JRKashani/Arduino/last_chance/docs/diagrams/distance-sensors-wiring.png

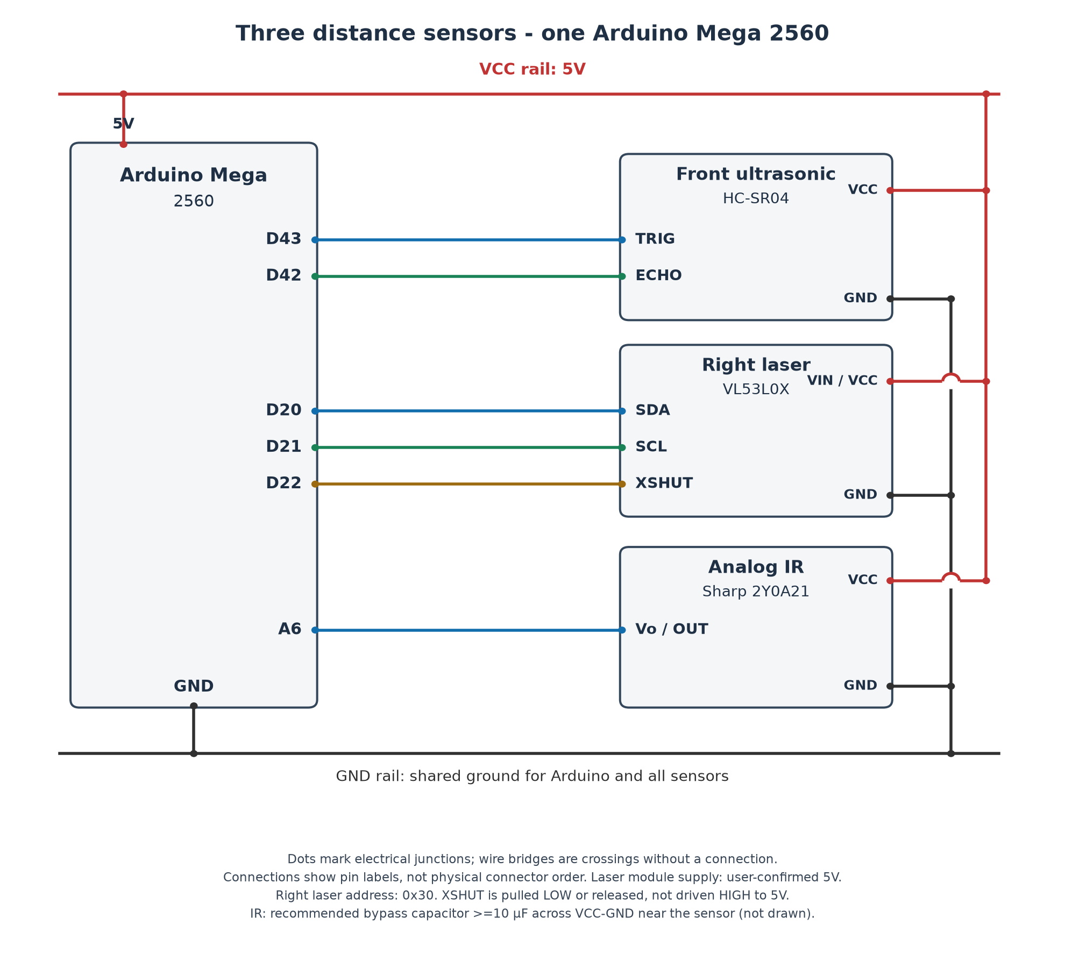
last_chance/docs/diagrams/distance-sensors-wiring.png
