JRKashani/Arduino/last_chance/docs/diagrams/imu-wiring.png

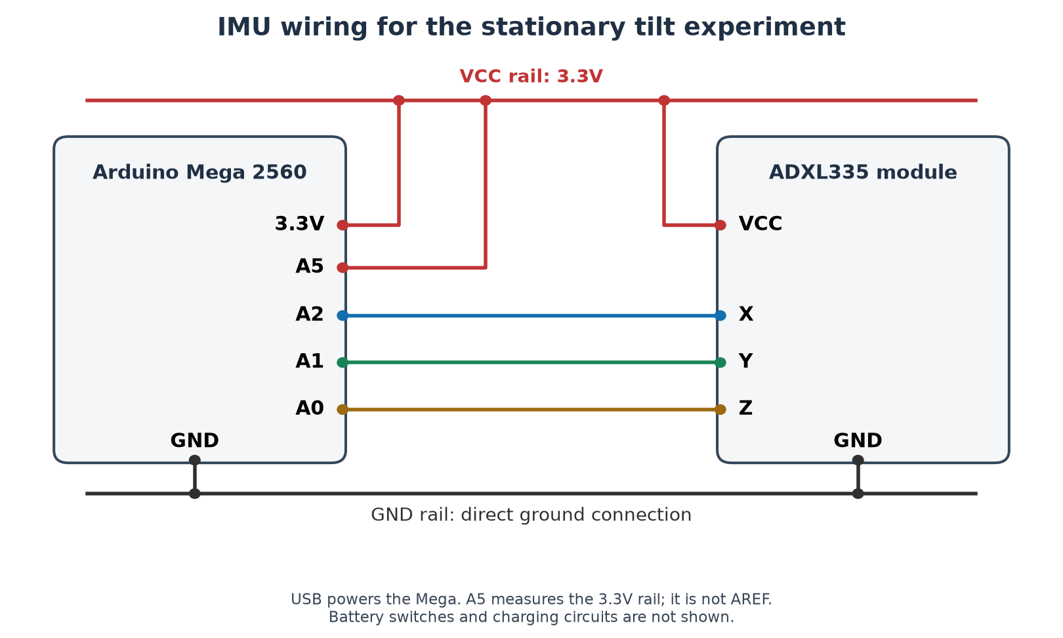
last_chance/docs/diagrams/imu-wiring.png
