JRKashani/Arduino/last_chance/docs/distance-results-2026-10-11/comparison/three-sensor-characteristic.pdf

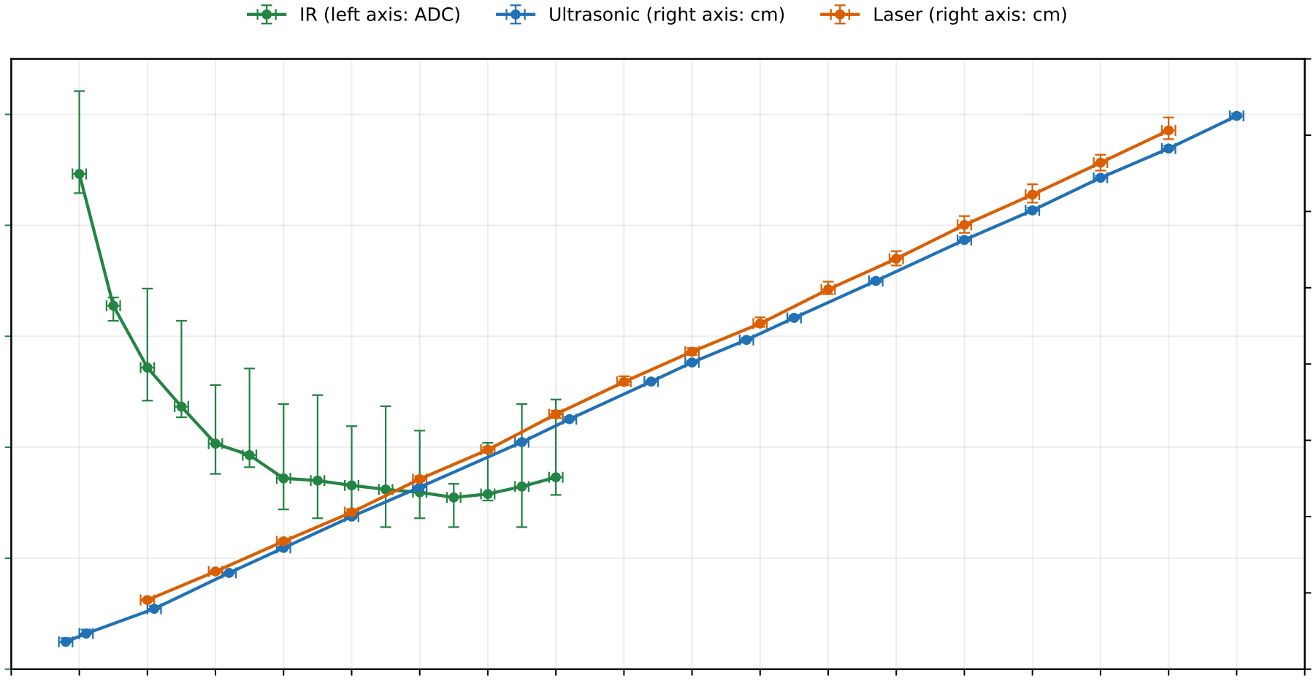
[picture p6: figure]
IR (left axis: ADC); Ultrasonic (right axis: cm); Laser (right axis: cm)

0 | 10 | 20 | 30 | 40 | 50 | 60 | 70 | 80 | 90 | 100 | 110 | 120 | 130 | 140 | 150 | 160 | 170 | 180 | 190

### Distance measured with tape, from sensor face (cm)

0

100

200

300

400

500

### IR output (ADC counts)

# Three-sensor distance characteristic

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
### Ultrasonic / laser reported distance (cm)

Points: mean of 3 accepted repeats. Vertical bars: minimum–maximum of all accepted samples.

Horizontal bars: ±1 cm tape-measure uncertainty (2 cm total width).
US uses existing calibration; laser uses reported cm. IR remains in ADC counts.
Laser mounting changed around 60 cm; this curve retains the original run.
The two y-axes use independent scales; curve intersections do not imply equal outputs.
