JRKashani/Arduino/last_chance/docs/distance-results-2026-10-11/raw-sensor-graphs/us-raw.pdf

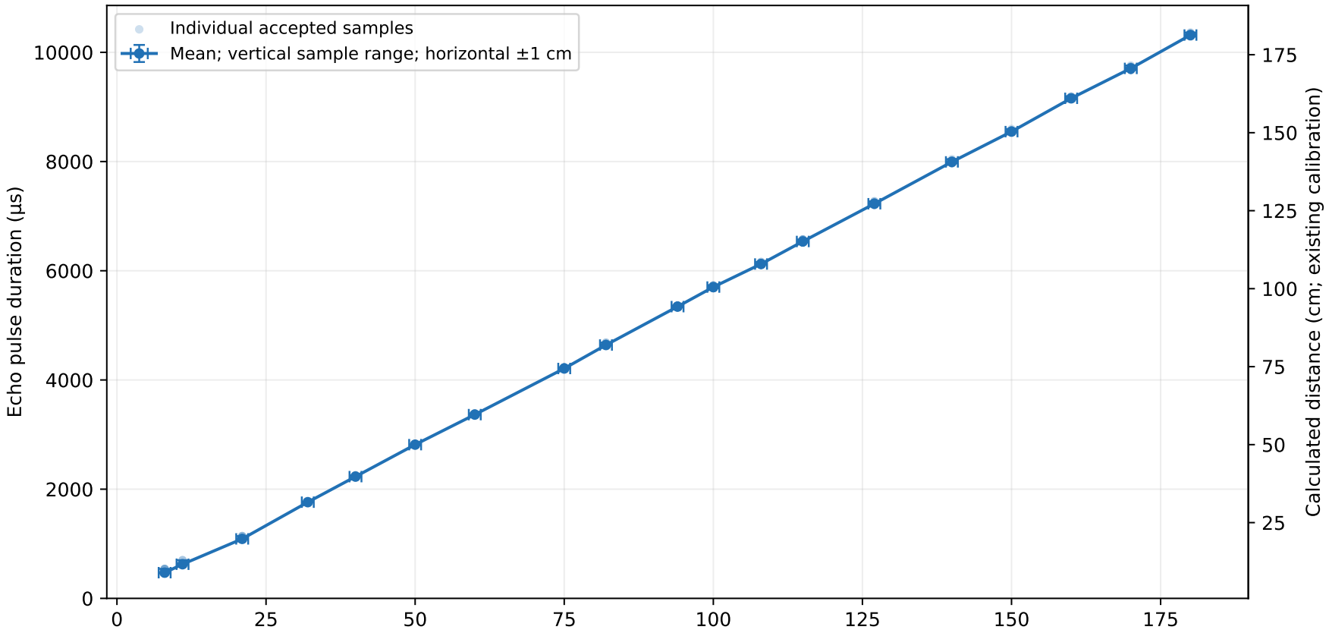
[picture p7: figure]
Calculated distance (cm; existing calibration); Echo pulse duration (µs); Individual accepted samples

Tape-measured distance from sensor face (cm)

## Ultrasonic sensor — raw echo time

Mean; vertical sample range; horizontal ±1 cm

Points: equally weighted mean of 3 accepted repeats; faint dots: individual raw samples. Vertical bars: minimum–maximum of accepted samples. Horizontal bars: ±1 cm (2 cm total). Right axis: cm = (echo µs / 58) × 1.01535 + 0.7091. The same points and bars use both scales.
