JRKashani/Arduino/last_chance/docs/distance-results-2026-10-11/raw-sensor-graphs/plotted-data.csv

sensor | session | actual_cm | x_error_minus_cm | x_error_plus_cm | raw_mean | raw_min | raw_max | raw_unit | valid_samples | calculated_cm_mean | calculated_cm_min | calculated_cm_max
ir | 20261011T152446_019469Z_ir | 10.0 | 1 | 1 | 446.3333333333333 | 429 | 521 | ADC counts | 30
ir | 20261011T152446_019469Z_ir | 15.0 | 1 | 1 | 327.5333333333333 | 314 | 335 | ADC counts | 30
ir | 20261011T152446_019469Z_ir | 20.0 | 1 | 1 | 271.76666666666665 | 242 | 343 | ADC counts | 30
ir | 20261011T152446_019469Z_ir | 25.0 | 1 | 1 | 236.56666666666666 | 227 | 314 | ADC counts | 30
ir | 20261011T152446_019469Z_ir | 30.0 | 1 | 1 | 203.23333333333335 | 176 | 256 | ADC counts | 30
ir | 20261011T152446_019469Z_ir | 35.0 | 1 | 1 | 192.93333333333334 | 182 | 271 | ADC counts | 30
ir | 20261011T152446_019469Z_ir | 40.0 | 1 | 1 | 172.0 | 144 | 239 | ADC counts | 30
ir | 20261011T152446_019469Z_ir | 45.0 | 1 | 1 | 169.93333333333334 | 136 | 247 | ADC counts | 30
ir | 20261011T152446_019469Z_ir | 50.0 | 1 | 1 | 165.63333333333333 | 136 | 219 | ADC counts | 30
ir | 20261011T152446_019469Z_ir | 55.0 | 1 | 1 | 161.96666666666667 | 128 | 237 | ADC counts | 30
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
