JRKashani/Arduino/last_chance/docs/distance-results-2026-10-11/20261011T134101_190940Z_us/analysis/20261011T141951_366159Z/measurements.xlsx

Sheet: Experiment
Front HC-SR04
Curve definition | Minimum / mean / maximum of separate accepted capture means
schema | 1
created_utc | 2026-10-11T13:41:01.190940+00:00
sensor | us
sensor_description | Front HC-SR04
simulated | FALSE
points_cm | [200, 175, 150, 125, 100, 80, 60, 50, 40, 30, 25, 20, 15, 10]
repeats | 3
samples_per_capture | 10
period_ms | 500
settle_ms | 500
distance_origin | sensor_face
adc_reference_v | 5
adc_reference_source | nominal
firmware_config | {"US_SCALE": "1.015350", "US_OFFSET_CM": "0.709100", "US_TIMEOUT_US": "30000", "US_CALIBRATION_RANGE_CM": "15:150", "IR_PIN": "A6", "IR_MODEL": "GP2Y0A21YK0F", "ADC_REFERENCE": "AVCC", "LASER_PROFILE": "default_33ms_single_shot", "DISTANCE_ORIGIN": "sensor_face"}
firmware_version | 1.0.0
setup_notes

Sheet: Samples
point_index | target_cm | actual_cm | repeat | capture_id | included | decision | superseded_point | sequence | timestamp_ms | raw | valid | status | device_status | raw_cm | calibrated_cm | voltage
1 | 200 | 200 | 1 | 1 | FALSE | skipped | TRUE | 0 | 322189 | 0 | FALSE | NO_ECHO | -1
1 | 200 | 200 | 1 | 1 | FALSE | skipped | TRUE | 1 | 322289 | 0 | FALSE | NO_ECHO | -1
1 | 200 | 200 | 1 | 1 | FALSE | skipped | TRUE | 2 | 322390 | 0 | FALSE | NO_ECHO | -1
1 | 200 | 200 | 1 | 1 | FALSE | skipped | TRUE | 3 | 322490 | 0 | FALSE | NO_ECHO | -1
1 | 200 | 200 | 1 | 1 | FALSE | skipped | TRUE | 4 | 322590 | 0 | FALSE | NO_ECHO | -1
1 | 200 | 200 | 1 | 1 | FALSE | skipped | TRUE | 5 | 322690 | 0 | FALSE | NO_ECHO | -1
1 | 200 | 200 | 1 | 1 | FALSE | skipped | TRUE | 6 | 322790 | 0 | FALSE | NO_ECHO | -1
1 | 200 | 200 | 1 | 1 | FALSE | skipped | TRUE | 7 | 322890 | 0 | FALSE | NO_ECHO | -1
1 | 200 | 200 | 1 | 1 | FALSE | skipped | TRUE | 8 | 322990 | 0 | FALSE | NO_ECHO | -1
1 | 200 | 200 | 1 | 1 | FALSE | skipped | TRUE | 9 | 323090 | 0 | FALSE | NO_ECHO | -1
1 | 180 | 180 | 1 | 2 | TRUE | accepted | FALSE | 0 | 108954 | 4076 | TRUE | OK | -1 | 70.27586207 | 72.06369655
1 | 180 | 180 | 1 | 2 | TRUE | accepted | FALSE | 1 | 109454 | 3473 | TRUE | OK | -1 | 59.87931034 | 61.50755776
1 | 180 | 180 | 1 | 2 | TRUE | accepted | FALSE | 2 | 109954 | 3522 | TRUE | OK | -1 | 60.72413793 | 62.36535345
1 | 180 | 180 | 1 | 2 | TRUE | accepted | FALSE | 3 | 110454 | 3672 | TRUE | OK | -1 | 63.31034483 | 64.99125862
1 | 180 | 180 | 1 | 2 | TRUE | accepted | FALSE | 4 | 110954 | 3523 | TRUE | OK | -1 | 60.74137931 | 62.38285948
1 | 180 | 180 | 1 | 2 | TRUE | accepted | FALSE | 5 | 111454 | 3573 | TRUE | OK | -1 | 61.60344828 | 63.25816121
1 | 180 | 180 | 1 | 2 | TRUE | accepted | FALSE | 6 | 111954 | 3548 | TRUE | OK | -1 | 61.17241379 | 62.82051034
1 | 180 | 180 | 1 | 2 | TRUE | accepted | FALSE | 7 | 112454 | 3597 | TRUE | OK | -1 | 62.01724138 | 63.67830603
1 | 180 | 180 | 1 | 2 | TRUE | accepted | FALSE | 8 | 112954 | 3947 | TRUE | OK | -1 | 68.05172414 | 69.8054181
1 | 180 | 180 | 1 | 2 | TRUE | accepted | FALSE | 9 | 113454 | 3897 | TRUE | OK | -1 | 67.18965517 | 68.93011638

Sheet: Captures
point_index | point_id | target_cm | actual_cm | repeat | capture_id | decision | included | complete | samples | valid_samples | requested_samples | period_ms | settle_ms | raw_min | raw_mean | raw_max | raw_std | raw_cm_min | raw_cm_mean | raw_cm_max | raw_cm_std | calibrated_cm_min | calibrated_cm_mean | calibrated_cm_max | calibrated_cm_std | voltage_min | voltage_mean | voltage_max | voltage_std
1 | 2d2e0a82a0844c6d9f750905f05c7ea4 | 200 | 200 | 1 | 1 | skipped | FALSE | TRUE | 10 | 0 | 10 | 100 | 1000
1 | b7a7c84e476840808e9e09828e3fdaa0 | 180 | 180 | 1 | 2 | accepted | TRUE | TRUE | 10 | 10 | 10 | 500 | 500 | 3473 | 3682.8 | 4076 | 211.7135381 | 59.87931034 | 63.49655172 | 70.27586207 | 3.650233416 | 61.50755776 | 65.18032379 | 72.06369655 | 3.706264499

Sheet: Summary
point_index | target_cm | actual_cm | completed | accepted_captures | usable_captures | valid_samples | total_samples | within_nominal_range | within_us_calibration_range | three_usable_repeats | raw_min | raw_mean | raw_max | raw_std | raw_cm_min | raw_cm_mean | raw_cm_max | raw_cm_std | calibrated_cm_min | calibrated_cm_mean | calibrated_cm_max | calibrated_cm_std | voltage_min | voltage_mean | voltage_max | voltage_std | error_cm
1 | 180 | 180 | FALSE | 1 | 1 | 10 | 10 | TRUE | FALSE | FALSE | 3682.8 | 3682.8 | 3682.8 | 0 | 63.49655172 | 63.49655172 | 63.49655172 | 0 | 65.18032379 | 65.18032379 | 65.18032379 | 0 |  |  |  |  | -114.8196762
