JRKashani/Arduino/last_chance/docs/distance-results-2026-10-11/20261011T152053_543501Z_laser/analysis/20261011T152435_927208Z/summary.csv

point_index | target_cm | actual_cm | completed | accepted_captures | usable_captures | valid_samples | total_samples | within_nominal_range | within_us_calibration_range | three_usable_repeats | raw_min | raw_mean | raw_max | raw_std | raw_cm_min | raw_cm_mean | raw_cm_max | raw_cm_std | calibrated_cm_min | calibrated_cm_mean | calibrated_cm_max | calibrated_cm_std | voltage_min | voltage_mean | voltage_max | voltage_std | error_cm
4 | 50.0 | 50.0 | True | 3 | 3 | 30 | 30 | True |  | True | 510.7 | 511.73333333333335 | 512.9 | 1.1060440015357957 | 51.07 | 51.17333333333333 | 51.29 | 0.11060440015358002 | 51.07 | 51.17333333333333 | 51.29 | 0.11060440015358002 |  |  |  |  | 1.173333333333332
3 | 60.0 | 60.0 | True | 3 | 3 | 30 | 30 | True |  | True | 618.6 | 620.1 | 621 | 1.3076696830621994 | 61.86 | 62.01 | 62.1 | 0.1307669683062211 | 61.86 | 62.01 | 62.1 | 0.1307669683062211 |  |  |  |  | 2.009999999999998
2 | 70.0 | 70.0 | True | 3 | 3 | 30 | 30 | True |  | True | 718.2 | 719.7666666666667 | 720.9 | 1.4011899704655526 | 71.82 | 71.97666666666666 | 72.09 | 0.14011899704656258 | 71.82 | 71.97666666666666 | 72.09 | 0.14011899704656258 |  |  |  |  | 1.9766666666666595
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
