JRKashani/Arduino/last_chance/docs/distance-results-2026-10-11/raw-sensor-graphs/ir-reference-trace.csv

distance_cm | approximate_voltage_V | equivalent_ADC_at_4_71V
1 | 0.8 | 173.7579617834395
2 | 1.12 | 243.26114649681534
3 | 1.55 | 336.65605095541406
4 | 1.92 | 417.0191082802547
5 | 1.8 | 390.95541401273886
6 | 2.14 | 464.8025477707007
7 | 2.48 | 538.6496815286624
8 | 2.62 | 569.0573248407644
9 | 2.59 | 562.5414012738853
10 | 2.45 | 532.1337579617835
12 | 2.2 | 477.8343949044587
14 | 2.01 | 436.56687898089166
16 | 1.63 | 354.03184713375794
18 | 1.5 | 325.79617834394907
20 | 1.4 | 304.0764331210191
22 | 1.29 | 280.1847133757962
25 | 1.16 | 251.94904458598722
28 | 1.05 | 228.05732484076435
30 | 0.99 | 215.02547770700636
35 | 0.9 | 195.47770700636943
40 | 0.76 | 165.07006369426753
45 | 0.69 | 149.86624203821654
50 | 0.63 | 136.8343949044586
55 | 0.6 | 130.3184713375796
60 | 0.58 | 125.97452229299361
65 | 0.54 | 117.28662420382167
70 | 0.51 | 110.77070063694268
75 | 0.5 | 108.59872611464968
80 | 0.49 | 106.42675159235668
