JRKashani/Arduino/last_chance/docs/distance-results-2026-10-11/20261011T152053_543501Z_laser/analysis/20261011T152435_927208Z/measurements.xlsx

Sheet: Experiment
Right VL53L0X
Curve definition | Minimum / mean / maximum of separate accepted capture means
schema | 2
created_utc | 2026-10-11T15:20:53.543501+00:00
sensor | laser
sensor_description | Right VL53L0X
simulated | FALSE
collection_mode | open_ended
repeats | 3
samples_per_capture | 10
period_ms | 500
settle_ms | 500
distance_origin | sensor_face
adc_reference_v | 5
adc_reference_source | nominal
firmware_config | {"US_SCALE": "1.015350", "US_OFFSET_CM": "0.709100", "US_TIMEOUT_US": "30000", "US_CALIBRATION_RANGE_CM": "15:150", "IR_PIN": "A6", "IR_MODEL": "GP2Y0A21YK0F", "ADC_REFERENCE": "AVCC", "LASER_PROFILE": "long_range_33ms_single_shot", "DISTANCE_ORIGIN": "sensor_face"}
firmware_version | 1.2.0
setup_notes
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
