JRKashani/Arduino/last_chance/docs/distance-results-2026-10-11/20261011T152053_543501Z_laser/analysis/20261011T152435_927208Z/samples.csv

point_index | target_cm | actual_cm | repeat | capture_id | included | decision | superseded_point | sequence | timestamp_ms | raw | valid | status | device_status | raw_cm | calibrated_cm | voltage
1 | 91.0 | 91.0 | 1 | 1 | True | accepted | False | 0 | 56576 | 958 | True | OK | 11 | 95.8 | 95.8
1 | 91.0 | 91.0 | 1 | 1 | True | accepted | False | 1 | 57076 | 955 | True | OK | 11 | 95.5 | 95.5
1 | 91.0 | 91.0 | 1 | 1 | True | accepted | False | 2 | 57576 | 956 | True | OK | 11 | 95.6 | 95.6
1 | 91.0 | 91.0 | 1 | 1 | True | accepted | False | 3 | 58076 | 956 | True | OK | 11 | 95.6 | 95.6
1 | 91.0 | 91.0 | 1 | 1 | True | accepted | False | 4 | 58576 | 948 | True | OK | 11 | 94.8 | 94.8
1 | 91.0 | 91.0 | 1 | 1 | True | accepted | False | 5 | 59076 | 946 | True | OK | 11 | 94.6 | 94.6
1 | 91.0 | 91.0 | 1 | 1 | True | accepted | False | 6 | 59576 | 950 | True | OK | 11 | 95.0 | 95.0
1 | 91.0 | 91.0 | 1 | 1 | True | accepted | False | 7 | 60076 | 964 | True | OK | 11 | 96.4 | 96.4
1 | 91.0 | 91.0 | 1 | 1 | True | accepted | False | 8 | 60576 | 955 | True | OK | 11 | 95.5 | 95.5
1 | 91.0 | 91.0 | 1 | 1 | True | accepted | False | 9 | 61076 | 950 | True | OK | 11 | 95.0 | 95.0
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
