JRKashani/Arduino/last_chance/docs/distance-results-2026-10-11/20261011T144802_531804Z_laser/analysis/20261011T150552_051989Z/captures.csv

point_index | point_id | target_cm | actual_cm | repeat | capture_id | decision | included | complete | samples | valid_samples | requested_samples | period_ms | settle_ms | raw_min | raw_mean | raw_max | raw_std | raw_cm_min | raw_cm_mean | raw_cm_max | raw_cm_std | calibrated_cm_min | calibrated_cm_mean | calibrated_cm_max | calibrated_cm_std | voltage_min | voltage_mean | voltage_max | voltage_std
1 | 955a29c8fc8f48d6ac156793464ac0b9 | 170.0 | 170.0 | 1 | 1 | accepted | True | True | 10 | 10 | 10 | 500 | 500 | 1737 | 1761 | 1800 | 20.741798914805393 | 173.7 | 176.1 | 180.0 | 2.074179891480541 | 173.7 | 176.1 | 180.0 | 2.074179891480541
1 | 955a29c8fc8f48d6ac156793464ac0b9 | 170.0 | 170.0 | 2 | 2 | accepted | True | True | 10 | 10 | 10 | 500 | 500 | 1764 | 1775.1 | 1808 | 12.314851016376753 | 176.4 | 177.51 | 180.8 | 1.2314851016376784 | 176.4 | 177.51 | 180.8 | 1.2314851016376784
1 | 955a29c8fc8f48d6ac156793464ac0b9 | 170.0 | 170.0 | 3 | 3 | accepted | True | True | 10 | 10 | 10 | 500 | 500 | 1749 | 1760.8 | 1776 | 9.589345939924973 | 174.9 | 176.07999999999998 | 177.6 | 0.9589345939924981 | 174.9 | 176.07999999999998 | 177.6 | 0.9589345939924981
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
