JRKashani/Arduino/last_chance/docs/distance-results-2026-10-11/20261011T144802_531804Z_laser/analysis/20261011T150552_051989Z/samples.csv

point_index | target_cm | actual_cm | repeat | capture_id | included | decision | superseded_point | sequence | timestamp_ms | raw | valid | status | device_status | raw_cm | calibrated_cm | voltage
1 | 170.0 | 170.0 | 1 | 1 | True | accepted | False | 0 | 58801 | 1742 | True | OK | 11 | 174.2 | 174.2
1 | 170.0 | 170.0 | 1 | 1 | True | accepted | False | 1 | 59301 | 1758 | True | OK | 11 | 175.8 | 175.8
1 | 170.0 | 170.0 | 1 | 1 | True | accepted | False | 2 | 59801 | 1758 | True | OK | 11 | 175.8 | 175.8
1 | 170.0 | 170.0 | 1 | 1 | True | accepted | False | 3 | 60301 | 1753 | True | OK | 11 | 175.3 | 175.3
1 | 170.0 | 170.0 | 1 | 1 | True | accepted | False | 4 | 60801 | 1737 | True | OK | 11 | 173.7 | 173.7
1 | 170.0 | 170.0 | 1 | 1 | True | accepted | False | 5 | 61301 | 1748 | True | OK | 11 | 174.8 | 174.8
1 | 170.0 | 170.0 | 1 | 1 | True | accepted | False | 6 | 61801 | 1794 | True | OK | 11 | 179.4 | 179.4
1 | 170.0 | 170.0 | 1 | 1 | True | accepted | False | 7 | 62301 | 1766 | True | OK | 11 | 176.6 | 176.6
1 | 170.0 | 170.0 | 1 | 1 | True | accepted | False | 8 | 62801 | 1754 | True | OK | 11 | 175.4 | 175.4
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
