JRKashani/Arduino/last_chance/docs/distance-results-2026-10-11/20261011T144802_531804Z_laser/analysis/20261011T150552_051989Z/summary.csv

point_index | target_cm | actual_cm | completed | accepted_captures | usable_captures | valid_samples | total_samples | within_nominal_range | within_us_calibration_range | three_usable_repeats | raw_min | raw_mean | raw_max | raw_std | raw_cm_min | raw_cm_mean | raw_cm_max | raw_cm_std | calibrated_cm_min | calibrated_cm_mean | calibrated_cm_max | calibrated_cm_std | voltage_min | voltage_mean | voltage_max | voltage_std | error_cm
16 | 20.0 | 20.0 | True | 3 | 3 | 30 | 30 | True |  | True | 225.6 | 226.63333333333333 | 227.7 | 1.0503967504392457 | 22.560000000000002 | 22.663333333333334 | 22.77 | 0.10503967504392353 | 22.560000000000002 | 22.663333333333334 | 22.77 | 0.10503967504392353 |  |  |  |  | 2.663333333333334
15 | 30.0 | 30.0 | True | 3 | 3 | 30 | 30 | True |  | True | 320 | 320.1333333333333 | 320.4 | 0.23094010767583717 | 32.0 | 32.013333333333335 | 32.04 | 0.02309401076758454 | 32.0 | 32.013333333333335 | 32.04 | 0.02309401076758454 |  |  |  |  | 2.0133333333333354
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
