JRKashani/Arduino/last_chance/docs/imu-results-2026-10-11/tables/x-tilt-g.csv

phone_angle_deg | X_g | Y_g | Z_g | surface | heading | loops | source_trial_ids
-34.256 | -0.551897834 | 0.043946615 | 0.8414317060000001 | S5 | 0 | 1;2 | 43;47
-20.002 | -0.33380335499999997 | 0.06861187499999999 | 0.949079606 | S4 | 0 | 1;2 | 34;38
-14.01 | -0.22895164899999998 | 0.069854763 | 0.979319847 | S3 | 0 | 1;2 | 24;28
-8.754 | -0.141043585 | 0.069884043 | 0.99499125 | S2 | 0 | 1;2 | 15;19
-4.257 | -0.060359365 | 0.064798806 | 1.002617856 | S1 | 0 | 1;2 | 5;9
0.0 | 0.014815390666666668 | 0.0712180845 | 1.0043523600833333 | FLAT_REFERENCE | 0 | 0 | 1;2;3;4;13;14;23;33;42;51
4.257 | 0.08401466 | 0.07240590999999999 | 1.002087491 | S1 | 180 | 1;2 | 7;11
8.754 | 0.16258007800000002 | 0.071297232 | 0.990873464 | S2 | 180 | 1;2 | 17;21
14.01 | 0.263296295 | 0.07153019099999999 | 0.968863776 | S3 | 180 | 1;2 | 26;30
20.002 | 0.353608397 | 0.063222719 | 0.9381679439999999 | S4 | 180 | 1;2 | 36;40
34.256 | 0.574385689 | 0.09277275499999998 | 0.814546383 | S5 | 180 | 1;2 | 45;49
