JRKashani/Arduino/last_chance/docs/imu-results-2026-10-11/tables/x-tilt-raw.csv

phone_angle_deg | X_raw | Y_raw | Z_raw | surface | heading | loops | source_trial_ids
-34.256 | 307.41200000000003 | 354.66499999999996 | 406.256 | S5 | 0 | 1;2 | 43;47
-20.002 | 322.96 | 356.38 | 413.906 | S4 | 0 | 1;2 | 34;38
-14.01 | 330.727 | 356.756 | 416.40999999999997 | S3 | 0 | 1;2 | 24;28
-8.754 | 337.04200000000003 | 356.78 | 417.561 | S2 | 0 | 1;2 | 15;19
-4.257 | 342.415 | 355.99199999999996 | 417.615 | S1 | 0 | 1;2 | 5;9
0.0 | 347.996 | 356.66433333333333 | 417.98466666666667 | FLAT_REFERENCE | 0 | 0 | 1;2;3;4;13;14;23;33;42;51
4.257 | 352.861 | 356.662 | 417.719 | S1 | 180 | 1;2 | 7;11
8.754 | 358.84799999999996 | 356.946 | 417.34000000000003 | S2 | 180 | 1;2 | 17;21
14.01 | 365.841 | 356.74800000000005 | 415.509 | S3 | 180 | 1;2 | 26;30
20.002 | 372.26599999999996 | 356.111 | 413.262 | S4 | 180 | 1;2 | 36;40
34.256 | 388.005 | 358.18600000000004 | 404.32500000000005 | S5 | 180 | 1;2 | 45;49
