JRKashani/Arduino/last_chance/docs/imu-results-2026-10-11/tables/y-tilt-g.csv

signed_slope_magnitude_deg | X_g | Y_g | Z_g | surface | heading | loops | source_trial_ids
-34.256 | -0.003719950999999999 | -0.487164155 | 0.884058954 | S5 | 90 | 1;2 | 44;48
-20.002 | 0.003487446 | -0.272733036 | 0.9722979439999999 | S4 | 90 | 1;2 | 35;39
-14.01 | 0.009707843 | -0.16729912800000002 | 0.9946949030000001 | S3 | 90 | 1;2 | 25;29
-8.754 | 0.004741636 | -0.075351169 | 1.0058388169999999 | S2 | 90 | 1;2 | 16;20
-4.257 | 0.00883175 | 0.0006589870000000001 | 1.007943927 | S1 | 90 | 1;2 | 6;10
0.0 | 0.014815390666666668 | 0.0712180845 | 1.0043523600833333 | FLAT_REFERENCE | 0 | 0 | 1;2;3;4;13;14;23;33;42;51
4.257 | 0.007562078999999999 | 0.14240960800000002 | 0.997535274 | S1 | 270 | 1;2 | 8;12
8.754 | 0.010429623999999998 | 0.21706910000000001 | 0.98330801 | S2 | 270 | 1;2 | 18;22
14.01 | 0.015343746 | 0.308359131 | 0.958333969 | S3 | 270 | 1;2 | 27;31
20.002 | 0.000727585 | 0.40931196400000003 | 0.9176683889999999 | S4 | 270 | 1;2 | 37;41
34.256 | 0.013116209 | 0.613324576 | 0.790872739 | S5 | 270 | 1;2 | 46;50
