JRKashani/Arduino/last_chance/docs/distance-results-2026-10-11/20261011T134101_190940Z_us/analysis/20261011T141951_366159Z/characteristic.png

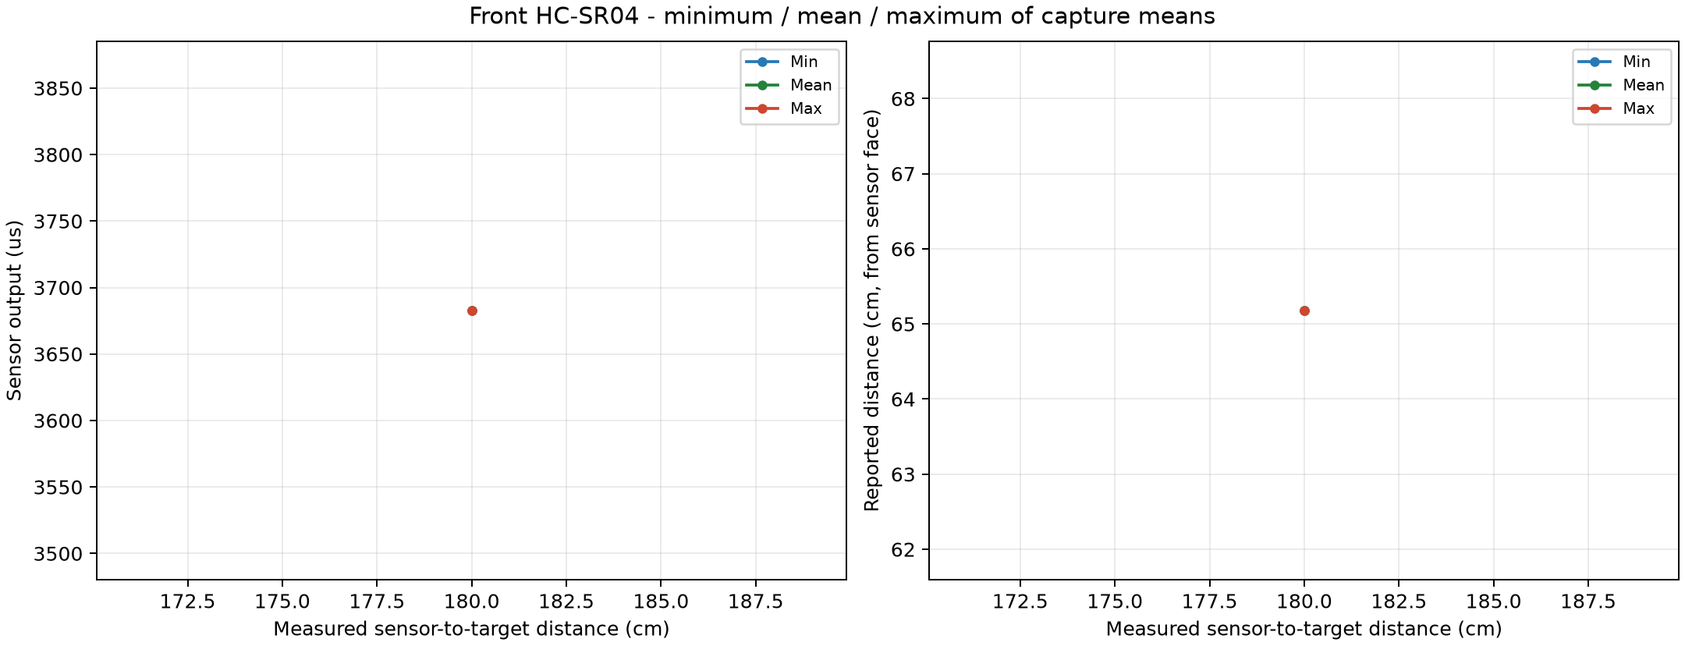
last_chance/docs/distance-results-2026-10-11/20261011T134101_190940Z_us/analysis/20261011T141951_366159Z/characteristic.png
