JRKashani/Arduino/last_chance/docs/distance-results-2026-10-11/20261011T152446_019469Z_ir/analysis/20261011T153412_479901Z/characteristic.png

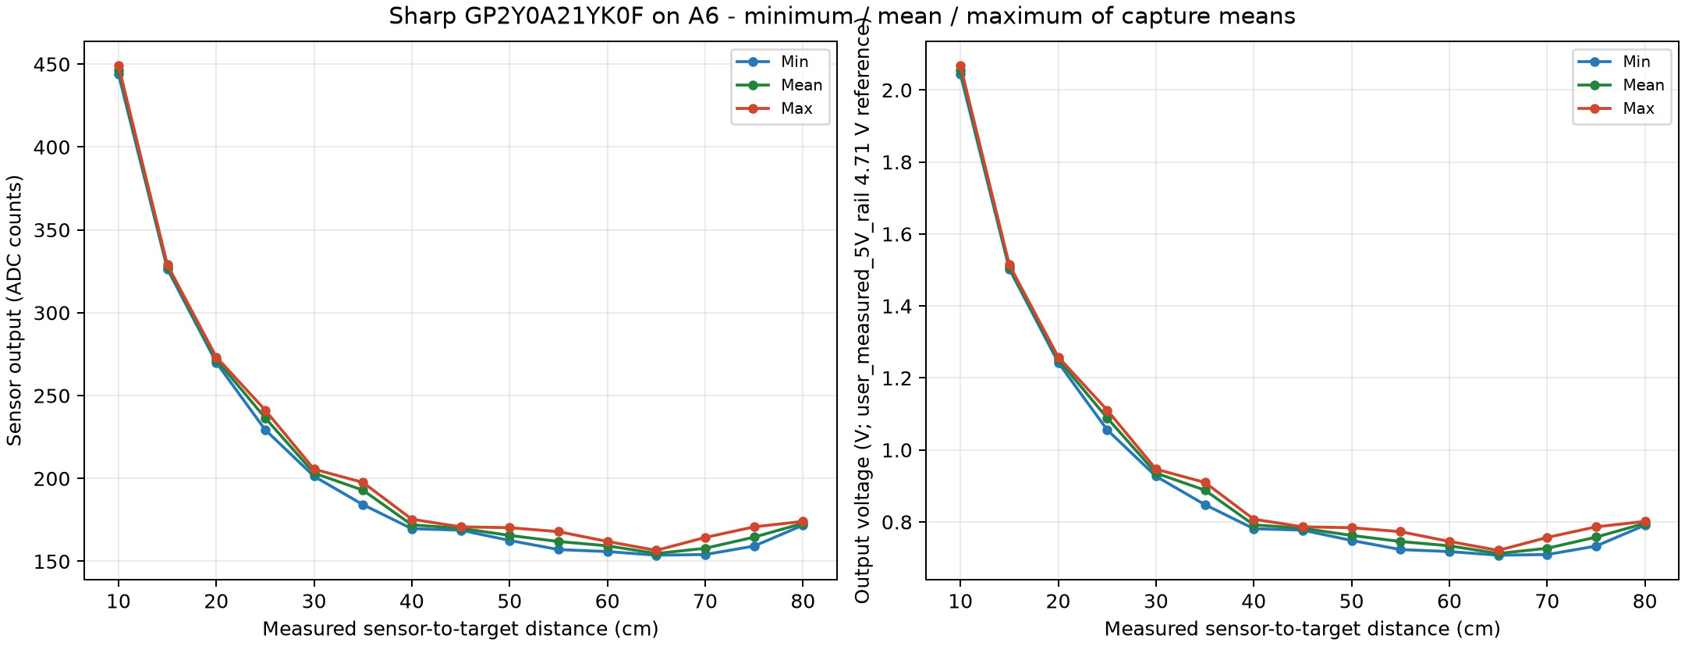
last_chance/docs/distance-results-2026-10-11/20261011T152446_019469Z_ir/analysis/20261011T153412_479901Z/characteristic.png
