JRKashani/Arduino/last_chance/docs/distance-results-2026-10-11/raw-sensor-graphs/ir-raw.png

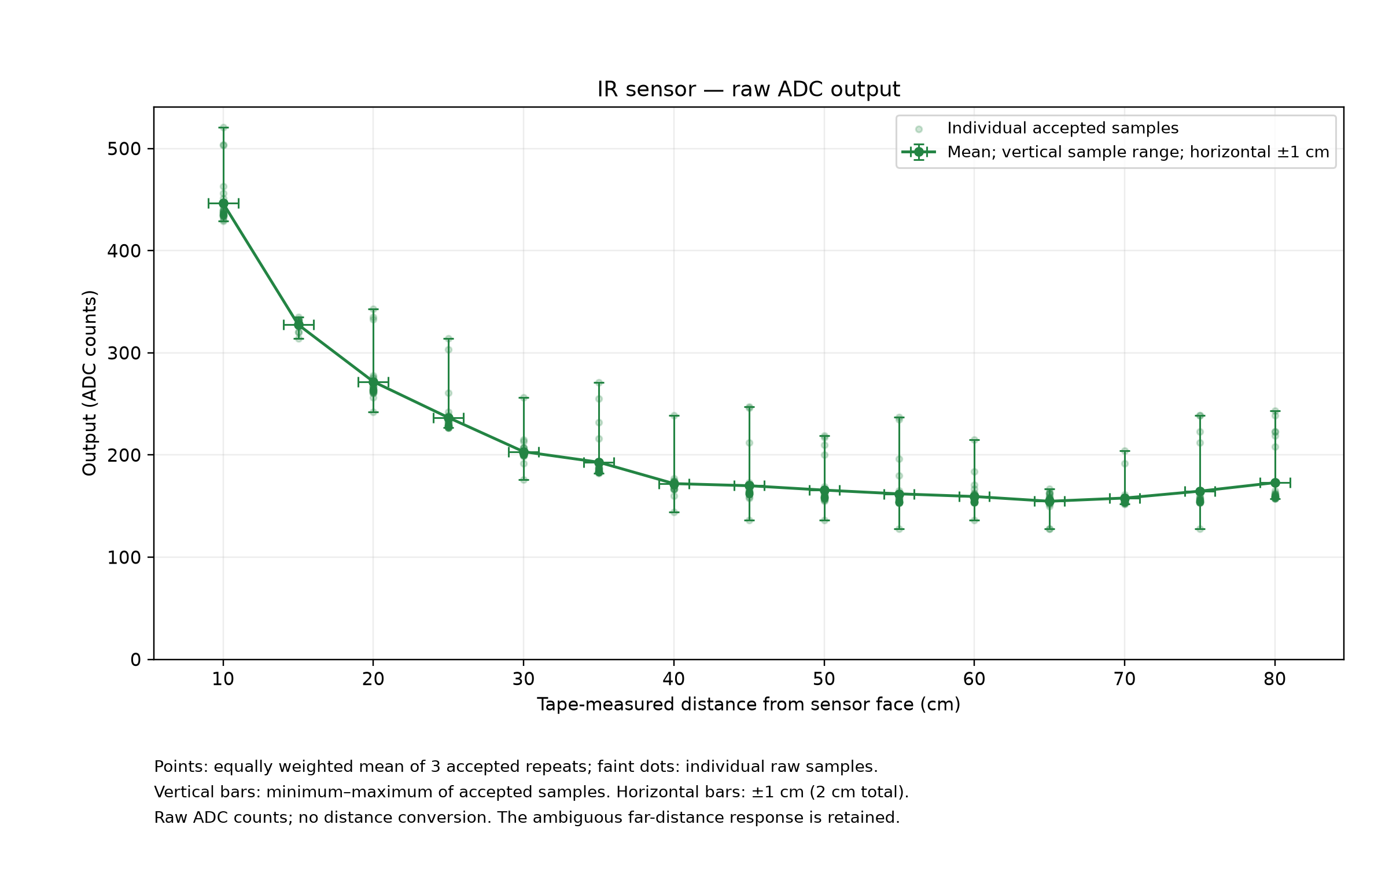
last_chance/docs/distance-results-2026-10-11/raw-sensor-graphs/ir-raw.png
