JRKashani/Arduino/last_chance/docs/imu-results-2026-10-11/calibration-review.png

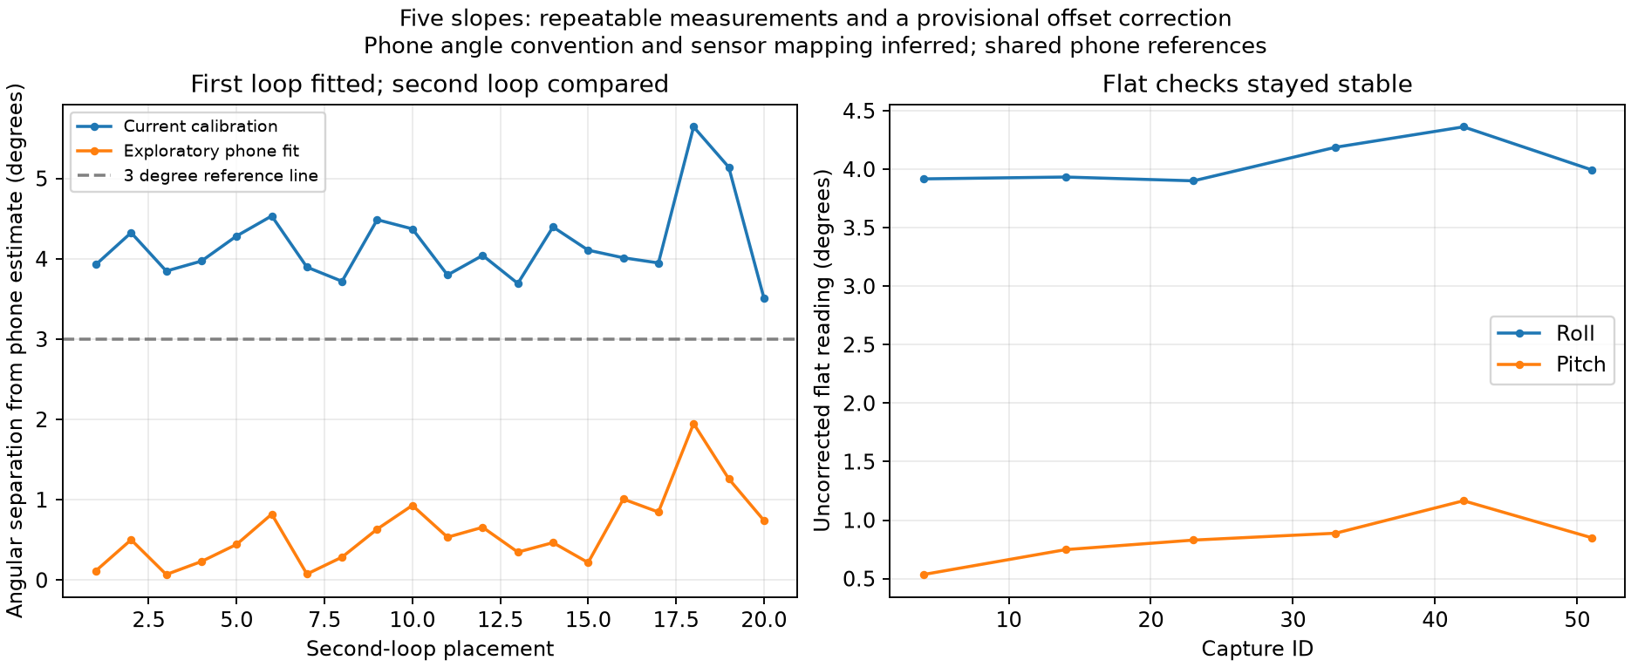
last_chance/docs/imu-results-2026-10-11/calibration-review.png
