JRKashani/Arduino/last_chance/docs/imu-results-2026-10-11/tables/measured-tables.png

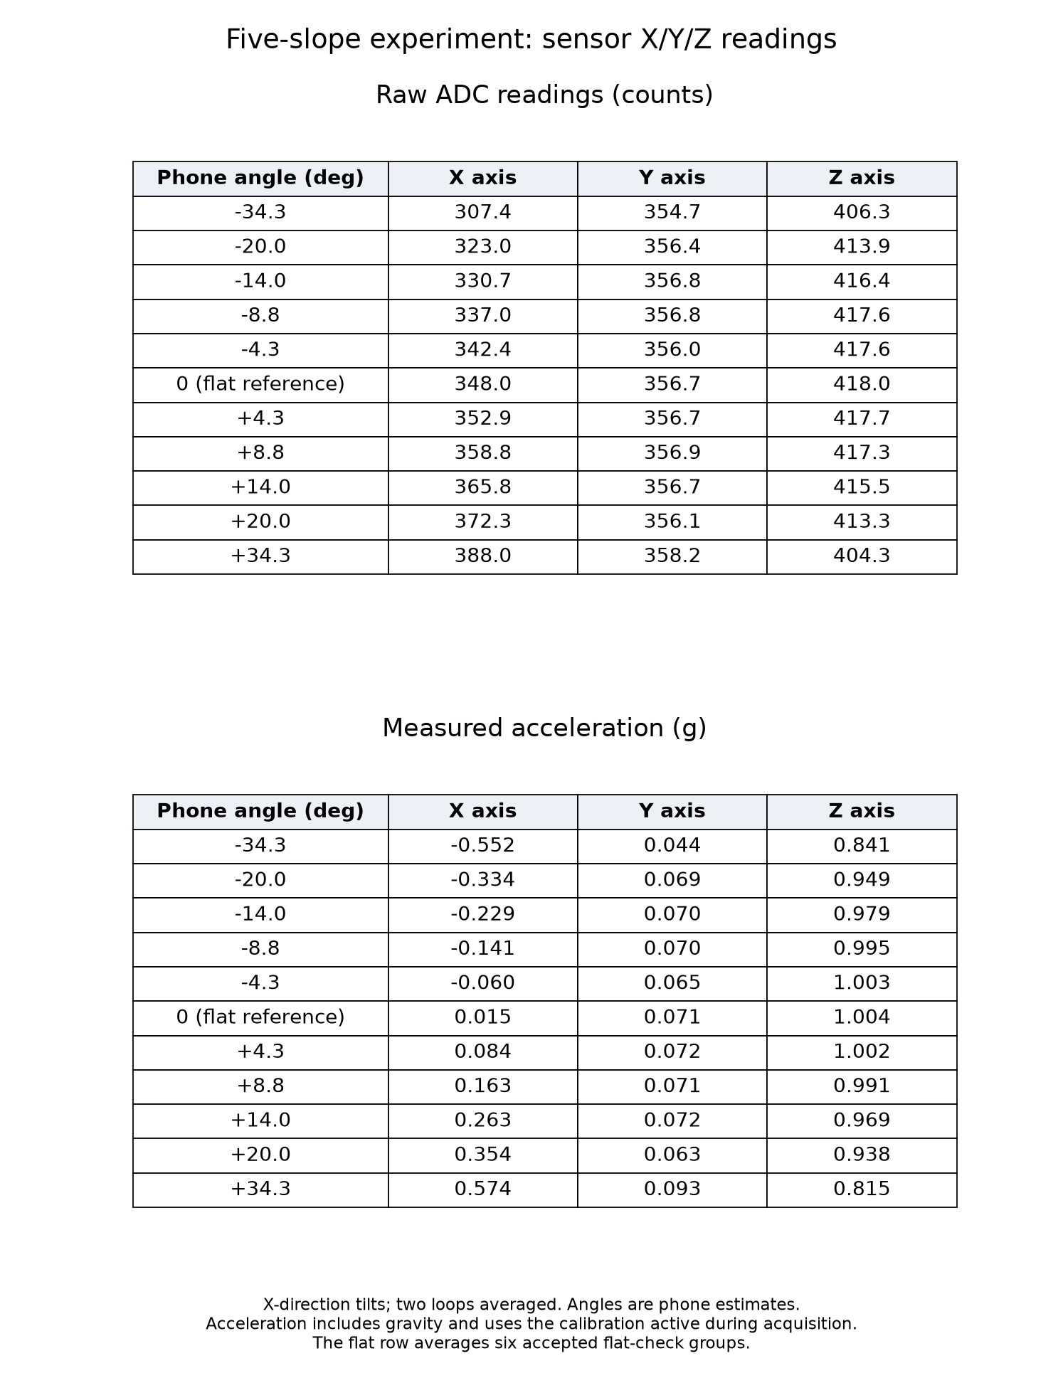
last_chance/docs/imu-results-2026-10-11/tables/measured-tables.png
