JRKashani/Arduino/last_chance/MotionCapsule.h

#ifndef MOTION_CAPSULE_H
#define MOTION_CAPSULE_H

#include <Arduino.h>

enum class TurnDirection { Left, Right };

void setupMotionCapsule();
// Call frequently from loop(), including during countdown and movement.
void runMotionCapsule();
// Return false for invalid requests or if another movement is pending/running.
// Accepted commands start after MOTION_COUNTDOWN_MS. No movement queue.
bool driveCm(float distanceCm);
bool turnQuarterCircle(TurnDirection direction);
bool motionBusy();
void stopMotion(); // Cancels countdown too.

#endif
