JRKashani/Arduino/(commit log)

2026-04-15 still missing some parts.
    [lab02.ino]
2026-08-09 Add Arduino motor and ultrasonic sketches
    Add multiple Arduino example files and assets: DualHBridgeSerial.ino and SerialDebugMotorsDriver.ino provide serial-keyboard controlled motor drivers (direction pins, PWM speed, slow/fast modes). Ultrasonic.ino is a simple HC-SR04 distance example; UltrasonicFunctions.ino introduces a placeholder refactor with setUltrasonicPins(), distanceCM(), and printDistance() left unimplemented. Also add supporting zip assets: Motor.zip, SteeringDualH.zip, Ultrasonic.zip, and Wheel.zip.
2026-08-09 Add Motor, SteeringDualH, Ultrasonic and Wheel libs
    Introduce four Arduino libraries and accompanying examples/keywords: Motor (motor control with setVelocity/flip/stop), SteeringDualH (dual-motor steering wrapper with bias support), Ultrasonic (HC-SR04 ranging), and Wheel (encoder-aware wheel control with interrupt handling, distance/velocity calculation). Adds example sketches for each library and a lab02 data archive (Motor.zip).
    [final_project.ino]
2026-08-09 Add VL53L0X library, demo sketch, steering fixes
    Add Pololu VL53L0X Arduino library (sources, README, LICENSE, examples, keywords, and library.properties). Add final_project/LAB5Q4.ino — a simple distance-based steering demo using an ultrasonic sensor and SteeringDualH. Add debug Serial prints in SteeringDualH.cpp to log velocity/bias calculations. Minor updates to Wheel (Wheel.cpp, Wheel.h) alongside the steering changes.
    [LAB5Q4.ino]
2026-08-09 Scaffold final_project and add info_input
    Add high-level scaffolding to final_project/final_project.ino: placeholder comments for initializing variables, stage declarations (open area, funnel, wall, wadi, flashlight), and loop flow (call info_vector, detect stage changes, activate movement functions). Add new empty file final_project/info_input.ino as a placeholder for input/information logic. Prepares the project for implementing stage handling and movement functions.
2026-08-09 Instantiate steering and ultrasonic sensors
    Create global instances for the robot: a SteeringDualH object (car) and four Ultrasonic sensors (US60, US120, US240, US300) initialized with their trig/echo pins. Also normalize brace/whitespace style for setup() and loop(). These changes prepare hardware objects for use in the sketch's setup and loop stages.
2026-08-09 Add Globals.h and remove global initializers
    Add Globals.h (includes Ultrasonic.h and SteeringDualH.h) and an empty Globals.CPP placeholder. Remove global object initializations (SteeringDualH car; Ultrasonic US60/US120/US240/US300) from final_project/final_project.ino to prepare centralizing globals in the new files.
2026-08-09 Add sensor data collection framework
    Archive legacy code to OLD/ directory and implement sensor data infrastructure. Add SensorReading struct to organize ultrasonic and motor data, implement info_input() function to populate sensor readings, and initialize hardware (Serial, LEDs, motor control). Also add debug output to loop. Note: Code contains a compilation error (THIS_SHOULD_NOT_COMPILE in Globals.CPP) that needs to be removed.
    [DualHBridgeSerial.ino, Globals.h, LAB5Q4.ino, SerialDebugMotorsDriver.ino, Ultrasonic.ino, UltrasonicFunctions.ino, final_project.ino, info_input.ino]
2026-08-09 Fix globals: pins, tolerances, and serial
    Remove stray non-compiling token and tidy Globals files: add #pragma once and Arduino include in Globals.h, split the single 'tolerance' into tolerance_US and tolerance_PhotoResistor (declared in Globals.h and defined in Globals.CPP), and correct trig/echo pin assignments for the 120cm sensor (from 4/5 to 6/7). Update final_project.ino serial output to label ultrasonic readings (US60/US120/US240/US300) and add spacing. Note: other code that referenced the old 'tolerance' symbol will need to use the new specific variables.
    [Globals.h, final_project.ino]
2026-08-09 Add Maze_Runner files; ultrasonic timeout
    Add Maze_Runner globals and a basic runner: new Globals_and_friends.h/.cpp (pin constants, Ultrasonic and SteeringDualH instances, SensorReading struct, currentData) and Maze_Runner.ino (serial test output of ultrasonic ranges). Minor change to final_project/info_input.ino to comment out timestamp write. Fix Ultrasonic.cpp to use pulseIn timeout (8000µs) to avoid blocking. Note: several pin values in Globals_and_friends.cpp are placeholders and may need real assignments.
    [Globals_and_friends.cpp, Globals_and_friends.h, Maze_Runner.ino, info_input.ino]
2026-08-10 Add initial Arduino hardware test sketches
    Add a set of Arduino test sketches under tests/: ADXL335_Test, Buttom_Test, HC_SR04_Test, IR_Distance_Test, LDR_Test, and VL53L0X_Test. Buttom_Test implements a debounced button tester using INPUT_PULLUP and prints state changes. HC_SR04_Test implements a HC-SR04 ultrasonic distance tester with a 30ms echo timeout and notes on wiring/timing. The other sketches are added as minimal templates/placeholders for future sensor tests.
2026-08-10 Add global sensor and motor configuration
    Initialize global variables and sensor struct for Romba robot navigation. Defines pin configurations for ultrasonic and laser sensors, motor control, speed constants, and tolerance thresholds. Creates SensorReading struct to store multi-sensor data.
    [Globals.cpp, Globals.h]
2026-08-10 Add Sensors module and update steering pins
    Add Romba_Maze/Sensors.cpp and Sensors.h implementing sensor pipeline: 3-sample rolling averages, HC-SR04 and VL53L0X readers, Sharp GP2Y distance conversion, ADXL335 accel conversion, 10ms analog sampling windows for IR and light sensors, value clearing, and stage-based readSensors(). Also update libraries/SteeringDualH/SteeringDualH.cpp to change default attach() pin mapping from (7,8,9,5,4,3) to (46,48,44,49,47,45) to match board wiring.
2026-08-10 Add pin constants and sensor objects
    Introduce named pin constants for motors, HC-SR04 ultrasonics, VL53L0X lasers, SHARP IR, LDRs, ADXL335 accelerometer, and the start button. Replace the old trigPin/echoPin variables with these constants and initialize Ultrasonic and VL53L0X instances using them. Add corresponding extern declarations to Globals.h to expose the new constants and objects, improving clarity of hardware mapping.
    [Globals.cpp, Globals.h]
2026-08-10 Reorganize old projects and update Romba_Maze pins
    Move Maze_Runner and final_project sources into OLD/ to separate legacy code. Update Romba_Maze/Globals.cpp with new hardware pin mappings (HC-SR04 trig/echo, LDR, ADXL pins), rename LASER_LEFT_XSHUT to LASER_FRONT_XSHUT, comment out IR pins, and add targetDistance variables and SensorReading instance. Add minimal Romba_Maze.ino skeleton (includes sensors.h and Serial.begin). Update tests/LDR_Test to use LDR_PIN = A7 to match new wiring.
2026-08-10 Refactor sensors and add stage framework
    Renamed and refactored sensor identifiers (laserLeft -> laserFront, ultrasonic variables suffixed with _cm) and added a white LED pin. Introduced a RobotStage enum and a skeleton getStage() implementation. Updated main sketch to initialize steering, use staged transition loops and switch on getStage(), and adjusted sensor reads accordingly. Modified Sensors API (setupSensors, readSensors returns const ref) and updated sensor read/clear logic to use the new names. Changes touch Globals.*, Sensors.*, Romba_Maze.ino and add getStage.ino to support stage-based behavior.
2026-08-10 Refactor sensors; add VL53L0X/I2C init
    Rework sensor globals and drivers for Mega + dual VL53L0X support. Moves Ultrasonic and VL53L0X instances into Globals.cpp and updates pin assignments (LASER_FRONT_XSHUT_PIN changed). Removes unused US240 and comments-out Sharp IR paths. Sensors.cpp is refactored: rolling-average helpers and read functions made static, new modular readers added (readUltrasonics, readLasers, readAccelerometer, readLightSensors), and a robust setupSensors() sequence initializes the two VL53L0X sensors via XSHUT and sets unique I2C addresses. readSensors(stage) now clears data and samples only needed sensors per stage. Romba_Maze.ino simplified to use setupSensors() and st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
    [Globals.cpp, Globals.h, I2C_Diag.ino, Romba_Maze.ino, Sensors.cpp, Sensors.h, VL53L0X_Test.ino]
2026-08-10 Add I2C scan and verbose VL53L0X debug setup
    Introduce a scanI2C helper and expand VL53L0X setup with step-by-step debug output. The setupSensors function now performs staged tests (powering down both sensors, releasing front, changing its address, releasing right, initializing both) with I2C scans and added delays to aid diagnosis of address/initialization issues. Error messages and success logs were clarified. No change to sensor logic beyond extra diagnostics and timing adjustments.
    [Romba_Maze.ino, Sensors.cpp]
2026-08-10 Remove host stubs; add VSCode config
    Replaced large host-side Arduino stubs in Romba_Maze.ino with real includes (<Arduino.h>, Sensors.h) and initialized currentStage. Added VSCode C/C++ IntelliSense config (.vscode/c_cpp_properties.json). Introduced a TwoWire stub fallback in Sensors.cpp when <Wire.h> isn't available to preserve non-Arduino builds. Added an empty funnelNavigation.ino placeholder. These changes simplify the sketch for real Arduino builds while keeping limited host compatibility via a minimal Wire stub.
    [Globals.cpp, HC_SR04_Test.ino, IR_Distance_Test.ino, Romba_Maze.ino, Sensors.cpp, openAreaNavigation.ino]
2026-08-10 VL53L0X test: add 3-sensor XSHUT round-robin
    Introduce a THREE_LASER_ROUND_ROBIN mode for the VL53L0X test sketch. Adds XSHUT pin configuration, laserOn/laserOff/allLasersOff helpers and readLaser() to wake, init and read a single sensor while others remain shut down. Loop now rotates through multiple sensors and prints per-laser results; original single-sensor continuous mode is preserved behind the compile-time flag. Error/timeouts return 0xFFFF and are reported via Serial.
    [VL53L0X_Test.ino]
2026-08-10 Add left laser sensor and refactor navigation
    Added support for a third VL53L0X laser sensor on the left side. Updated sensor initialization sequence to configure all three lasers with unique I2C addresses (front=0x30, right=0x31, left=0x32). Refactored openAreaNavigation to use laser distance measurements instead of ultrasonic sensors. Simplified Wire.h include logic and cleaned up debug code in setupSensors().
2026-08-10 Add LEDs and refine sensor/navigation logic
    Add red/green LED pins (defs and externs) for visual feedback. Replace readLaser with a robust implementation that handles timeouts and 0xFFFF sentinel, marks validity, updates a rolling average, and returns the immediate measurement for faster obstacle response. Adjust readSensors to skip ultrasonics in staged acquisition and ensure lasers are read. Modify openAreaNavigation to use LEDs and delays for non-driving visual testing: motion calls (straight/turn/stop) are commented out, front-threshold raised (100->200 mm), and red/green LEDs indicate turn direction. Also tidy up related comment blocks.
    [Globals.cpp, Globals.h, Sensors.cpp, openAreaNavigation.ino]
2026-08-10 Improve funnel nav, add LEDs, reduce speeds
    Lower default motor speeds for safer control (slow=30, fast=50, veryFast=100) and initialize red/green LED pins. Replace simple funnel routine with robust funnelNavigation: sensor validation, sum/delta geometry, exit detection, large-opening detection with timed correction, and LED indication. Increase open-area LED blink duration. Minor loop-stage adjustments (removed brief delay and adjusted stage transitions) to improve stage handoff and stability.
    [Globals.cpp, Romba_Maze.ino, openAreaNavigation.ino]
2026-08-10 Refactor funnel/open-area navigation logic
    Refactor funnelNavigation and openAreaNavigation to improve sensor validation, turn selection, and handling of front hazards and large side openings. Added configurable thresholds (SIDE_SEEN_MM, SIDE_CLOSE_MM, FRONT_CAUTION_MM, FRONT_DANGER_MM), lastTurnDirection and funnelConfirmCounter to stabilize behavior, and simplified correction/exit logic. Removed end-stage LED blinks and backed up previous openArea implementation to OLD/openAreaOLD.txt. Also adjusted car bias from 1 to 1.1 and clarified VL53L0X test pin comments.
    [Romba_Maze.ino, VL53L0X_Test.ino, openAreaNavigation.ino]
2026-08-10 Refactor open/funnel navigation; add motor test
    Simplify and harden navigation logic and add a motor calibration test.
    - Romba_Maze/Globals.{cpp,h}: change targetDistanceWall/Light from int to float and update values (300.0, 120.0) and externs.
    - Romba_Maze/funnelNavigation.ino: adjust turn signs, increase delays, add small delays after corrective turns, and scale turn magnitude by delta for smoother corrections.
    - Romba_Maze/openAreaNavigation.ino: replace complex open-area routine with a time-based drive-forward routine, add emergency front-stop and simple avoidance, and return early on obstacle. Old implementation preserved in OLD/openAreaOLD.txt.
    - tests/Motor_calib/Motor_calib.ino: new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
    [Globals.cpp, Globals.h, Motor_calib.ino, openAreaNavigation.ino]
2026-08-10 Add robot laser-scan navigation
    Add Navigation.h/cpp implementing LaserMinimum/LaserScanResult and scanWithRobot() which performs two sweeps (left/right) sampling lasers to record minimum distances and timestamps. Calibrated constants and input validation included. Also: include Navigation.h in Romba_Maze.ino, change car.setBias(1.1) -> car.setBias(11), and make FRONT_STOP_DISTANCE_MM a float (120.0f) in openAreaNavigation.ino. Files added: Romba_Maze/Navigation.h, Romba_Maze/Navigation.cpp; files modified: Romba_Maze/Romba_Maze.ino, Romba_Maze/openAreaNavigation.ino.
2026-08-10 Remove redundant forward declaration of readSensors
    Delete the unnecessary forward declaration `const SensorReading& readSensors(uint8_t stage);` from Romba_Maze/Sensors.cpp. The declaration is redundant (the function is declared/defined elsewhere) and removing it cleans up the source and avoids potential duplicate-declaration warnings.
    [Sensors.cpp]
2026-08-11 Add combined laser minima and scan UI
    Introduce combined laser minima (leftRight, leftFront, rightFront) to LaserScanResult and compute their summed minima and timestamps in scanWithRobot. Initialize new fields and preserve single-sensor minima. Update Romba_Maze.ino to provide an interactive serial-driven scanner: higher baud (115200), improved motor/sensor initialization, a quick static sensor check, printScanResult helper, and user prompt to press 'S' to run a scan and print results. Add Temp.txt (legacy/main sketch backup). These changes enable combined-beam heuristics and an easy manual test flow.
2026-08-11 Integrate funnel navigation into Navigation
    Move funnelNavigation into Navigation.cpp and remove funnelNavigation.ino. Add updateLeftRightBalance and a full funnel-navigation implementation (scan timing, angle helpers, obstacle selection, heading choice, and turn/correction utilities). scanWithRobot now updates left/right balance during scans. Expose funnelNavigation in Navigation.h. Minor runtime tweak: commented out a delay in Romba_Maze.ino. These changes consolidate funnel logic into the Navigation module and add safety/scan heuristics for robust funnel traversal.
    [Navigation.cpp, Navigation.h, Romba_Maze.ino]
2026-08-11 Add emergency escape during laser scan
    Detect very-close obstacles while sweeping and perform an emergency escape (turn away then back off). Implements emergencyEscapeDuringScan(), adds EMERGENCY_* constants and emergencyEscapePerformed flag to LaserScanResult. scanWithRobot now invokes the escape and returns early when performed. funnelNavigation updated to handle escapes, uses funnelStarted state and a safer default driveSpeed, and resets scan timers appropriately. Navigation.h adds prototypes and the new flag. Main loop resets wall-following when exiting funnel and advances from wall-following only when signaled. Prevents collisions during scan sweeps.
    [Navigation.cpp, Navigation.h, Romba_Maze.ino]
2026-09-26 Add robot motion and IMU calibration capsules
    This adds the last_chance sketch and supporting calibration, IMU, and motion test code for validating the robot platform. It includes the ADXL335 library, empirical motor calibration tables, timed movement capsules, serial command test UI, and verification/simulation assets for motor and sensor diagnostics.
2026-09-26 Archive legacy Arduino project files
    This change moves the existing Romba_Maze project and Wheel library files into an OLD/ archive layout without changing their contents. It is a repository organization update to preserve earlier Arduino sources separately from the active project structure.
2026-09-26 Convert last_chance to a PlatformIO project
    Restructure the last_chance sketch into a PlatformIO project layout in place:
    - move sources into src/ (git-tracked renames preserve history)
    - rename last_chance.ino to src/main.cpp and add explicit <Arduino.h> include
    - add platformio.ini targeting board megaatmega2560, framework arduino,
    monitor_speed 115200, and lib_extra_dirs ../libraries so the shared
    libraries remain the single source of truth
    - ignore .pio/ build output
    Builds clean for the Mega 2560 (LDF pulls ADXL335_IMU, SteeringDualH, Motor).
2026-09-26 Add unified sensor capsule with live telemetry to last_chance
    Add SensorsCapsule: dual-VL53L0X bring-up via XSHUT address assignment,
    direct HC-SR04 reads honoring the DEFINE.h echo timeout and distance
    calibration, LDR reads, 5-sample median filtering, and center-relative
    distance reporting using new mounting-offset constants. Add a serial-toggled
    (T) live telemetry dashboard. Wire updateSensors() into the main loop and
    drop the redundant runMotionCapsule() call. Hardware-verified on the robot.
2026-09-26 Add closed-loop control infrastructure and Stage 3 wall following
    - Control (lib/Control): pure proportional steering helper (deadband + clamp),
    Arduino-free and unit-tested on the host via a new [env:native] test env.
    - MotionCapsule: add driveContinuous(speed, steer) for live closed-loop drive,
    with a Manual state so the timed test machine stays out of the way.
    - StageManager: stage dispatch + front-distance safety stop + Stage 3
    right-wall following at 30 cm (center-relative) using the steering helper.
    - Serial console: 1-5 start a stage, X stops it; timed moves blocked while a
    stage runs. Wire runStageManager() into the main loop.
    Mega build and 4 native Control tests pass.
2026-09-26 Fix Stage 3 wall-follow steering sign (verified on hardware)
2026-09-26 Stage 3: PD wall following, per-site rate-limited logging, tuned gains
    - Revert steering sign to the hardware-verified mapping (positive = away
    from the right wall); the earlier flip drove the robot into the wall.
    - Add steerFromPD (P deadband, D always active) with native unit tests; Stage 3
    uses a fixed-cadence, low-passed approach rate as the damping/heading term.
    - Add Log.h: LOG_EVERY_MS/STAGE_LOG macros with a static timer per call site.
    - Log each Stage 3 decision (distance, error, rate, steer, clamp, front).
    - Tune: Kp 0.10, Kd 0.30 (model-based, ~critical damping), deadband 5 mm,
    clamp 25. Bench: converges without overshoot and holds 29-30.4 cm.
    [DEFINE.h, Log.h]
2026-09-26 Stage 3: slow down while steering hard (speed scheduling)
    Add scaleSpeedBySteer (linear DRIVE_SPEED -> WALL_FOLLOW_MIN_SPEED=30 at max
    steer) with native tests; Stage 3 uses it and logs the actual speed. Bench:
    hard inward start stays >=19 cm center (~11 cm side clearance), no overshoot,
    settles at 29.5-30.1 cm.
    [DEFINE.h]
2026-09-26 Stage 3: handle a lost wall (outside corner / wall end) with a search arc
    Wall counts as lost when invalid or beyond LASER_WALL_GONE_THRESHOLD_MM for
    WALL_LOST_CONFIRM_COUNT loops (glitch rejection, PD skipped meanwhile); then
    arc toward the wall until reacquired (derivative reset, no kick) or stop on
    WALL_SEARCH_TIMEOUT_MS. Logs each transition once.
    Bench: a 45 deg outside corner is handled by PD alone (wall never lost);
    the search path itself has not been exercised on hardware yet.
    [DEFINE.h]
2026-09-26 Stage 3: inside-corner anticipation; fix toward-steer bug; search hysteresis
    - Corner term ramps away-steer from front (60->30 cm) and right-45 (28->15 cm)
    via new rampByProximity (native-tested). While active, command is the
    more-away of PD and corner so the D term cannot cancel the turn.
    - Fix: apply that max only while the corner term is active (it previously
    discarded every toward-the-wall command, losing the wall).
    - Reacquire a lost wall only at <= WALL_REACQUIRE_MM (60 cm) vs 70 cm gone,
    stopping lost/found flapping.
    - Log r45, PD and corner contributions plus corner enter/clear.
    Bench on 3x45 cm practice wall: outside corner OK; inside corner min 26.2 cm
    (was 14 cm); wall en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
    [DEFINE.h]
2026-09-26 Stage 3: anti-chatter, dead-zone compensation, 8 s search timeout (UNTESTED ON HARDWARE)
    - Cap dErr at forward speed from the calibration fit (~124 mm/s): larger
    values are artifacts such as the beam sweeping a corner vertex.
    - Slew-limit the steer command (150/s) to stop +-25 bang-bang flips.
    - Add STEER_DEADZONE_COMP (4) while correcting distance, for the observed
    parallel travel at +-4 cm offset with small steer commands.
    - Raise WALL_SEARCH_TIMEOUT_MS to 8 s so a 90 deg outside corner (~5 s arc)
    fits. Log the pre-slew target (tgt).
    New helpers slewLimit/compensateDeadzone are native-tested (18/18 pass).
    Compiles for the Mega; NOT yet run on the robot.
    [DEFINE.h]
2026-09-26 Add HANDOFF.md: project state, setup, Stage 3 design/tuning, gaps, next steps
2026-09-26 last_chance cleanup: drop dead constants/code, split motor calibration, refresh README
    No behavior change (Mega build OK, 14/14 native tests pass).
    - Move motor balance, calibration tables and motion profile to
    src/MotorCalibration.h (kept as the measurement record); DEFINE.h includes it.
    - Remove unused: calibration-mode settings, TRACK_WIDTH_MM, old Stage 1/2
    constants, wall-history/majority, superseded ultrasonic constants, unused
    emergency constants, misleading *_TOF_FILTER_SIZE (filter is fixed at 5),
    steerFromError (replaced by steerFromPD) and its tests, sensorTelemetryEnabled.
    - README.md: short PlatformIO quick start pointing to HANDOFF.md.
    [DEFINE.h, MotorCalibration.h, SensorsCapsule.cpp, SensorsCapsule.h]
2026-10-11 Add stationary IMU mission and adopt replacement ADXL335
    Add the standalone motor-disabled firmware, guided five-slope recorder,
    six-face calibration workflow, repeat handling and offline analysis.
    Keep the replacement sensor six-face constants as the active default;
    record skipped validation and leave the phone-derived fit unapplied.
    Archive calibration provenance, wiring diagrams and measured ADC/g tables.
    Hardware tested: completed all 40 stationary slope placements with this
    replacement sensor; all 20 paired loop measurements agree within 3 deg
    per axis, with stable start/end flat checks.
    Validation: 32 Python tests, 5 mock-firmware scenarios (motor outputs zero),
    and successful Platfo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
2026-10-11 Publish full stationary IMU sample data
    Archive the unchanged 25,500-row CSV from the completed five-slope run,
    including all 51 capture attempts, raw ADC values and acceleration in g.
    Link it from the project overview and experiment/calibration records.
    Hardware source: completed stationary replacement-ADXL335 experiment.
    Verified byte-for-byte source match, sample count, capture count and columns.
2026-10-11 Add distance sensor mission and archive raw experiment results
2026-10-17 Add scripts for distance sensor data analysis and visualization
    - Implement `plot_comparison.py` to generate a three-sensor characteristic plot with experimental laser calibration.
    - Create `plot_raw_sensors.py` for individual raw-output figures of each sensor without altering combined figures.
    - Both scripts include data processing, error handling, and output generation in various formats (PNG, SVG, PDF).
    - Ensure data integrity with SHA256 checksums and provide detailed README documentation for reproducibility.
2026-10-18 Add script to overlay user-supplied voltage plot on IR data
    This commit introduces a new Python script, `plot_ir_reference.py`, which overlays an approximate trace of a user-supplied voltage plot on infrared (IR) measurement data. The script reads IR data, processes it, and generates a plot comparing the measured samples with a reference curve derived from user input. Additionally, it saves the plot in multiple formats and exports the reference data to a CSV file, along with metadata about the sources of the measurements.
2026-10-27 Remove machine-specific files and personal data from the tree
    Add a root .gitignore for secrets, editor files with absolute paths and
    local scratch. Stop tracking .vscode path files, the code-workspace and
    Temp.txt (kept locally, now ignored). Use a relative folder in the
    distance-test doc and the GitHub handle in the IMU library metadata.
2026-10-27 Apply measured laser/US calibration; add manual drive logger
    Calibration (navigation and manual_drive builds):
    - Side lasers run the long-range profile used in the 2026-10-11 experiment
    and apply its fit: corrected_cm = 0.969241451 * reported_cm - 0.699266228
    (fitted on the right laser, 20-170 cm; left assumed to match).
    - Ultrasonic echo timeout 10 -> 12 ms to cover the validated 180 cm.
    Manual drive logger (env:manual_drive, tools/manual_drive):
    - Firmware streams every sensor update (lasers, ultrasonics, LDRs, IMU,
    applied command) and accepts D,<speed>,<steer> from the PC, with a
    0.6 s watchdog stop and a front safety stop for forward motion.
    - PC tool drives from the keyboard,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
